ArmanAdilMangat/GENIE/enclosure/DESIGN_B_NO_TOF/SHEET.png

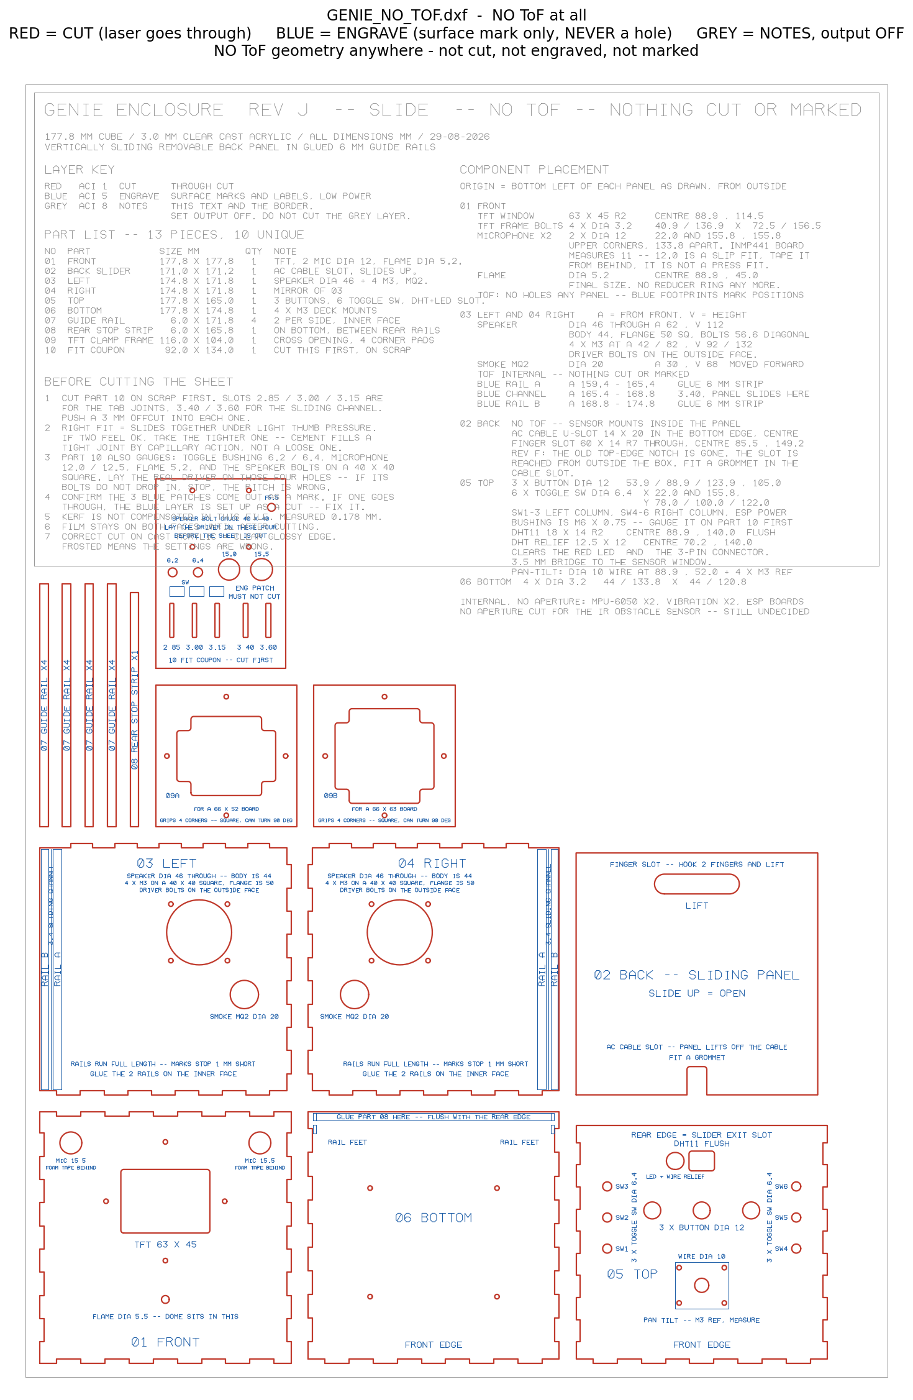
enclosure/DESIGN_B_NO_TOF/SHEET.png
