ArmanAdilMangat/GENIE/enclosure/PARTIAL_CUTS/COUPON_ONLY.png

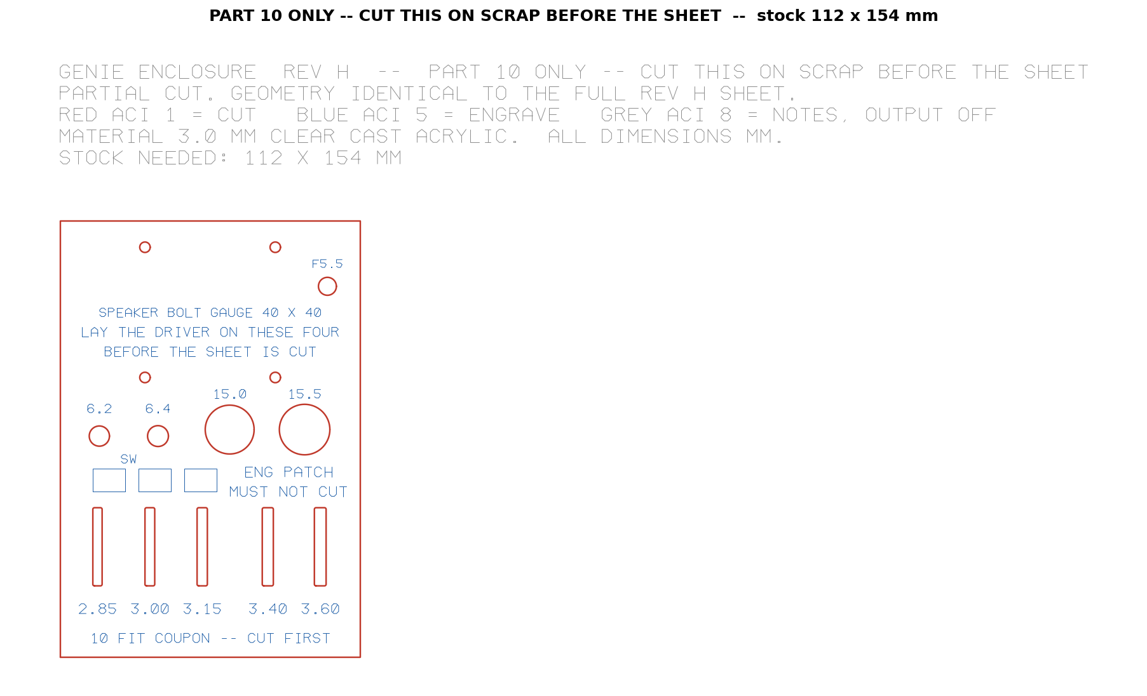
enclosure/PARTIAL_CUTS/COUPON_ONLY.png
