ArmanAdilMangat/GENIE/enclosure/PARTIAL_CUTS/REPLACEMENT_PANELS.png

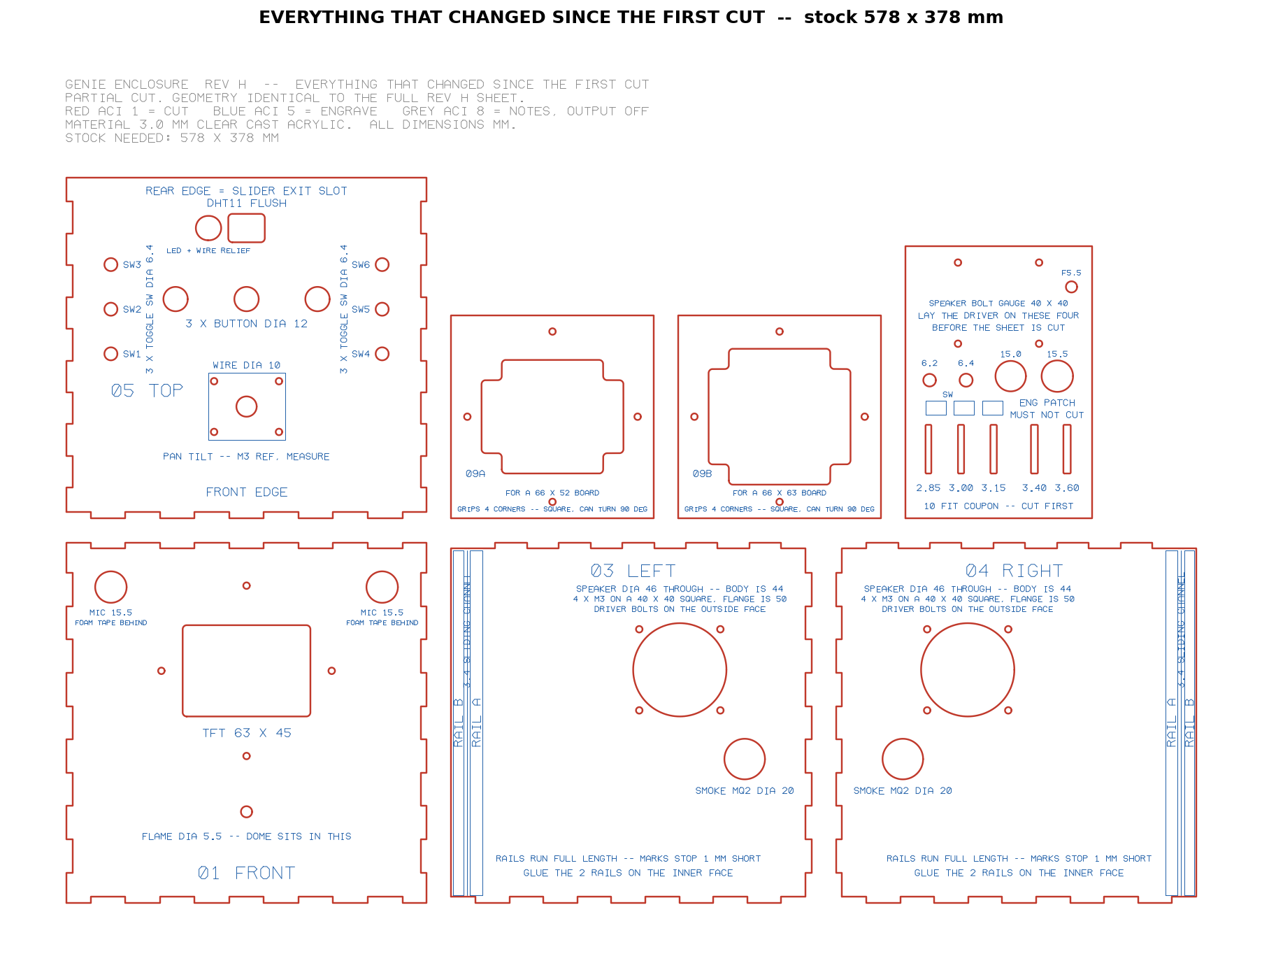
enclosure/PARTIAL_CUTS/REPLACEMENT_PANELS.png
