ArmanAdilMangat/GENIE/enclosure/PARTIAL_CUTS/SIDE_PANELS_ONLY.png

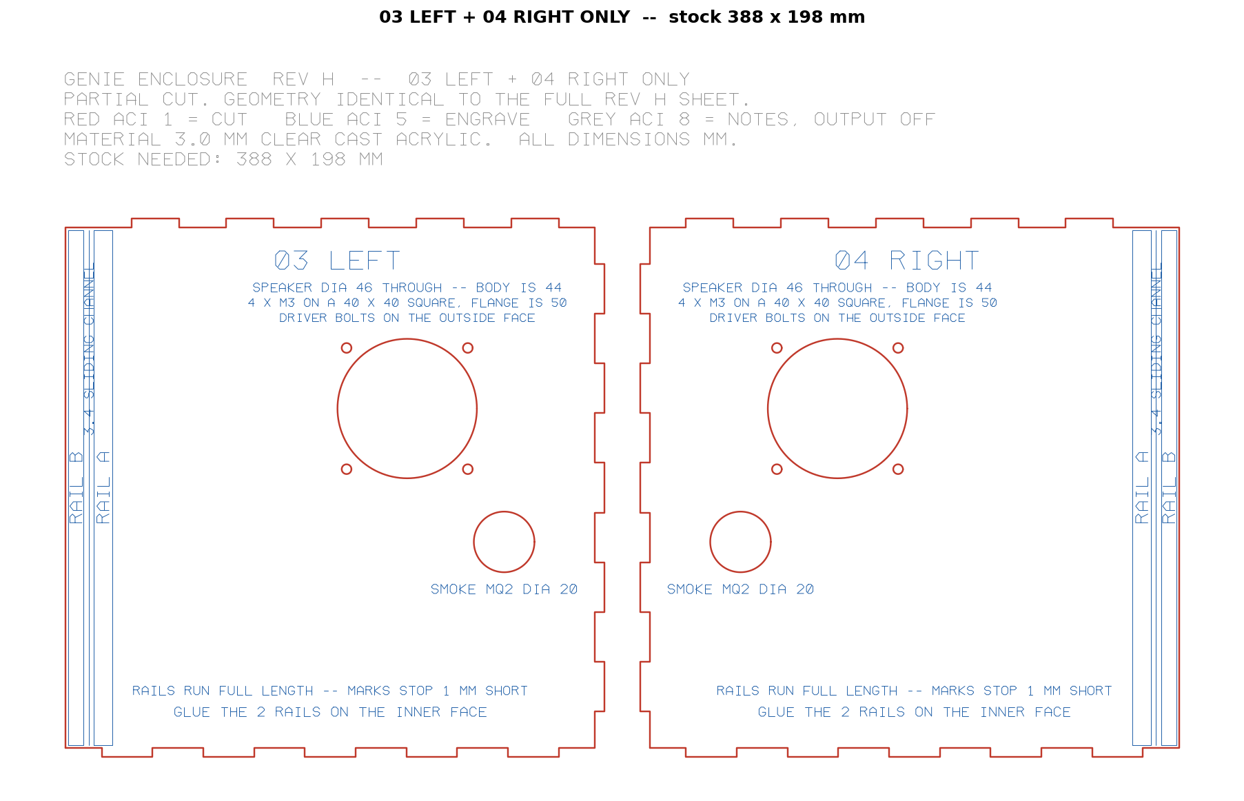
enclosure/PARTIAL_CUTS/SIDE_PANELS_ONLY.png
