ArmanAdilMangat/GENIE/enclosure/recut_2026-09-03/2_THREE_PLATES.png

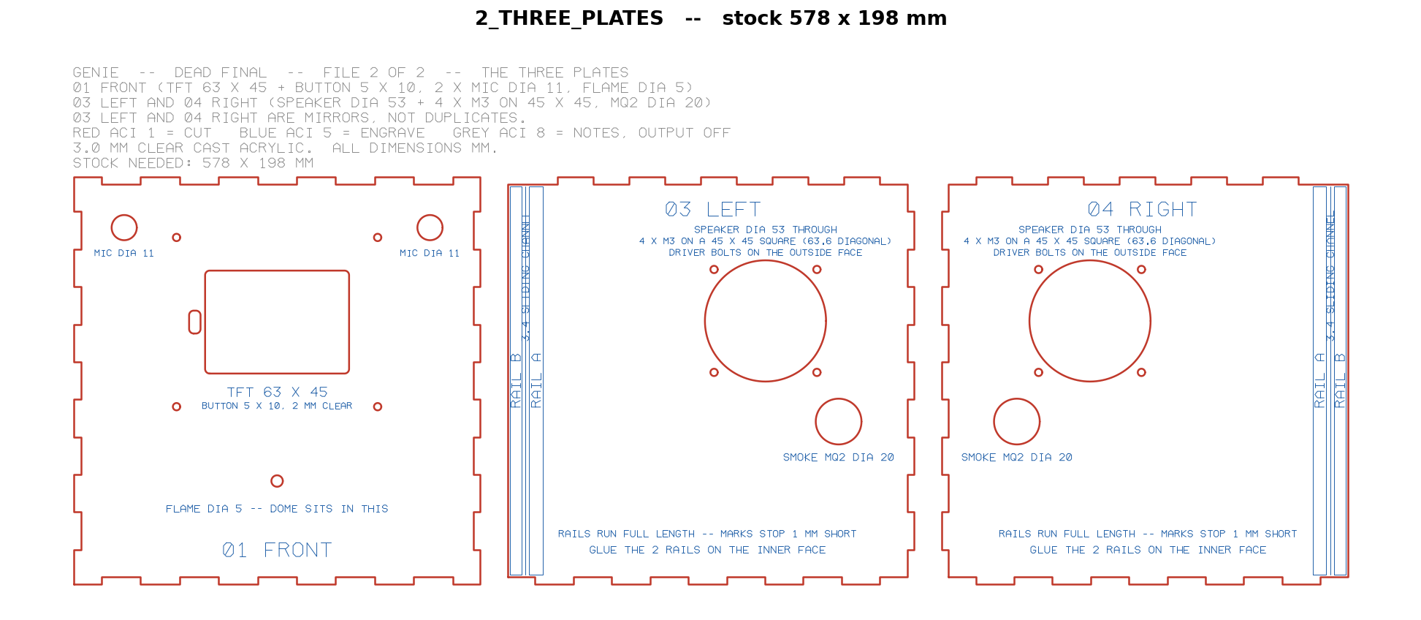
enclosure/recut_2026-09-03/2_THREE_PLATES.png
