ArmanAdilMangat/GENIE/enclosure/DESIGN_B_NO_TOF/GENIE_NO_TOF_blackred.dxf

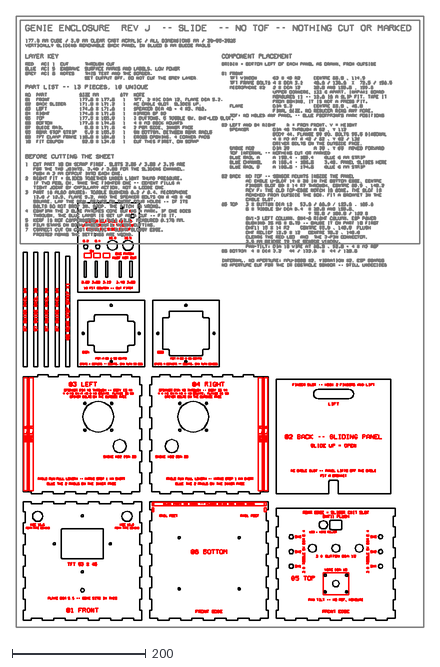
[picture p15: CAD file, 2026-10-06]
enclosure/DESIGN_B_NO_TOF/GENIE_NO_TOF_blackred.dxf
610.0 x 915.0
