ArmanAdilMangat/GENIE/enclosure/PARTIAL_CUTS/REPLACEMENT_PANELS.dxf

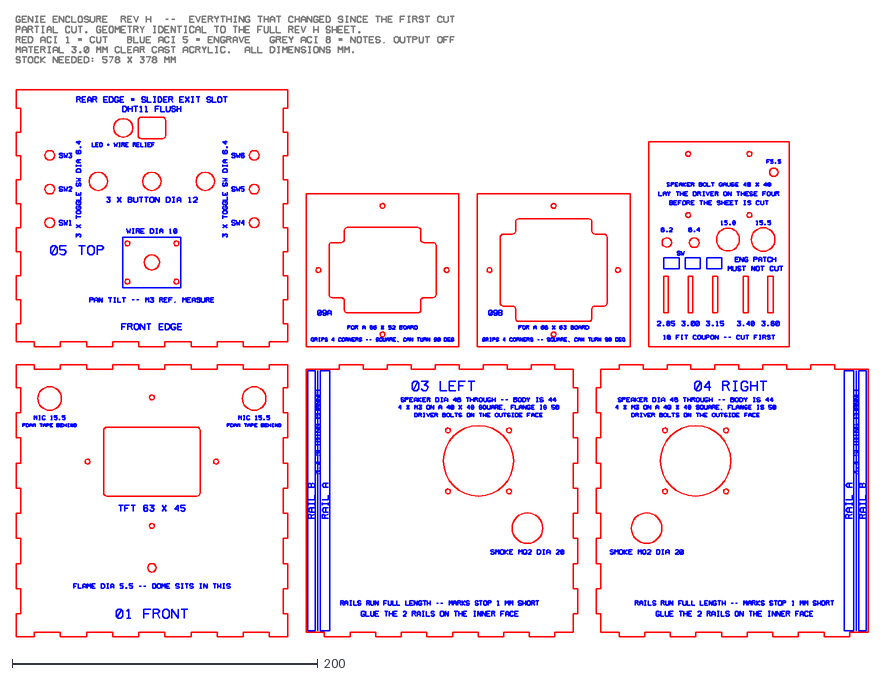
[picture p16: CAD file, 2026-10-06]
enclosure/PARTIAL_CUTS/REPLACEMENT_PANELS.dxf
557.4 x 405.8
