ArmanAdilMangat/GENIE/enclosure/recut_2026-09-03/1_TEST_TFT_MIC_SPEAKER.dxf

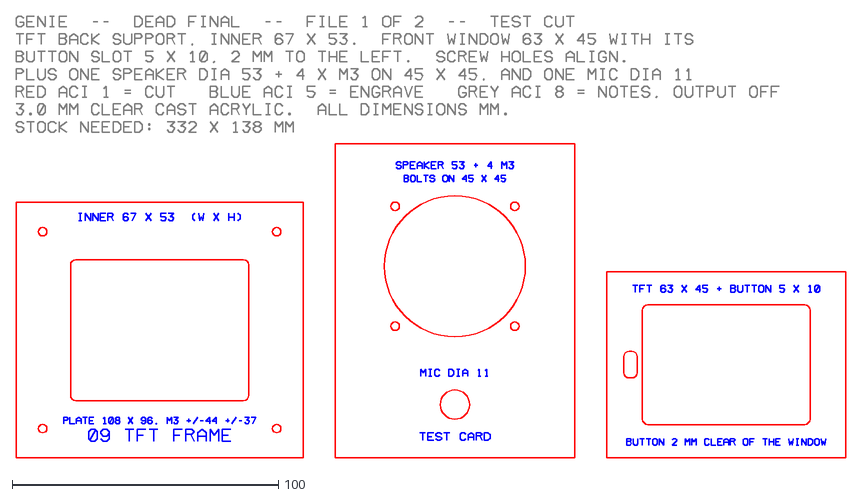
[picture p17: CAD file, 2026-10-06]
enclosure/recut_2026-09-03/1_TEST_TFT_MIC_SPEAKER.dxf
312.0 x 166.0
