ArmanAdilMangat/GENIE/enclosure/DESIGN_B_NO_TOF/GENIE_NO_TOF.dxf

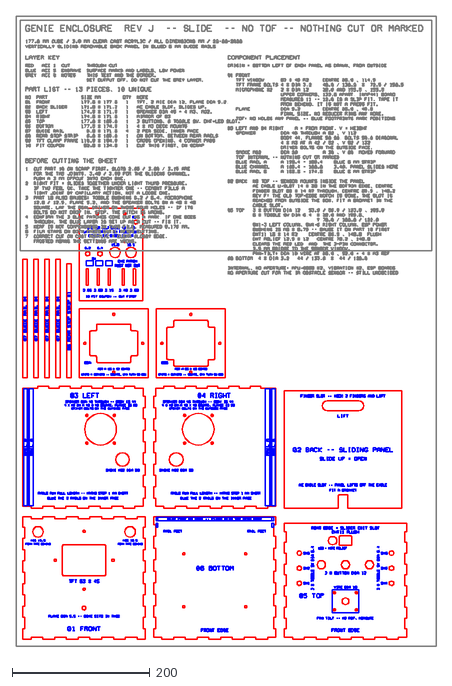
[picture p18: CAD file, 2026-10-06]
enclosure/DESIGN_B_NO_TOF/GENIE_NO_TOF.dxf
610.0 x 915.0
