ArmanAdilMangat/GENIE/enclosure/PARTIAL_CUTS/SIDE_PANELS_ONLY.dxf

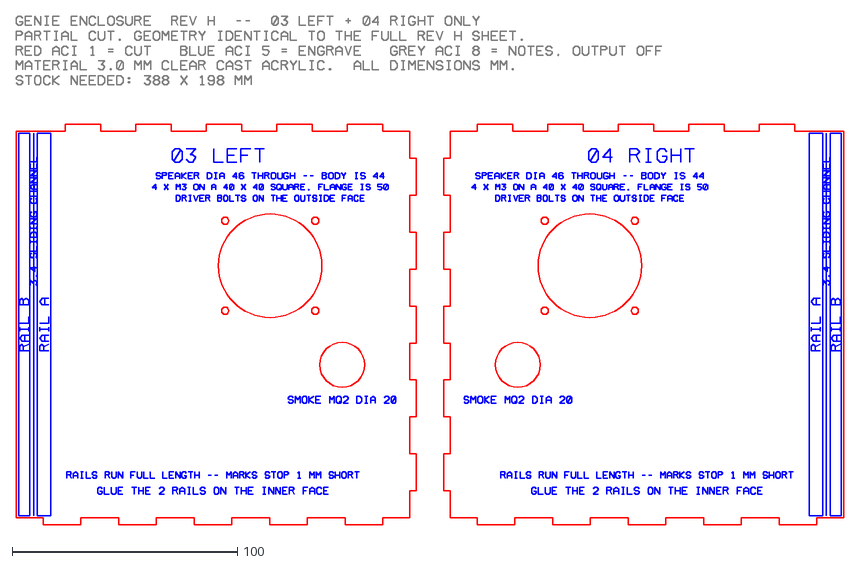
[picture p19: CAD file, 2026-10-06]
enclosure/PARTIAL_CUTS/SIDE_PANELS_ONLY.dxf
367.6 x 225.8
