ArmanAdilMangat/GENIE/enclosure/recut_2026-09-03/2_THREE_PLATES.dxf

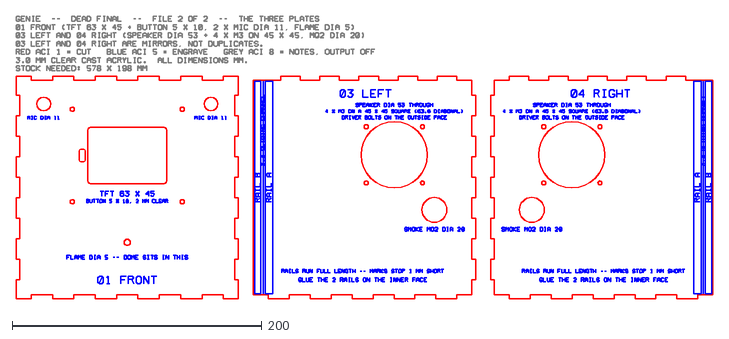
[picture p20: CAD file, 2026-10-06]
enclosure/recut_2026-09-03/2_THREE_PLATES.dxf
557.4 x 225.8
