ArmanAdilMangat/GENIE/enclosure/PARTIAL_CUTS/TEST_CUT_FIRST.dxf

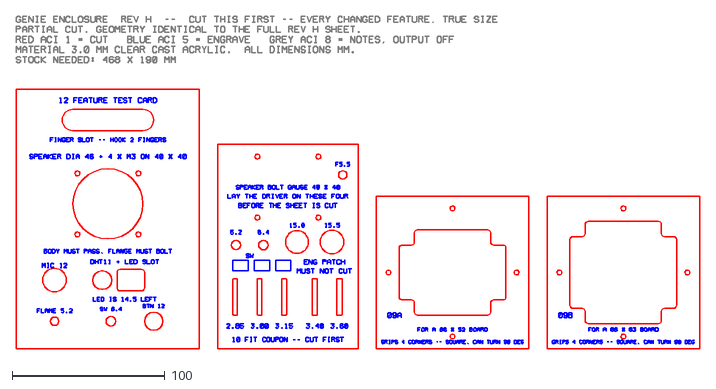
[picture p21: CAD file, 2026-10-06]
enclosure/PARTIAL_CUTS/TEST_CUT_FIRST.dxf
448.0 x 218.0
