ArmanAdilMangat/GENIE/enclosure/PARTIAL_CUTS/COUPON_ONLY.dxf

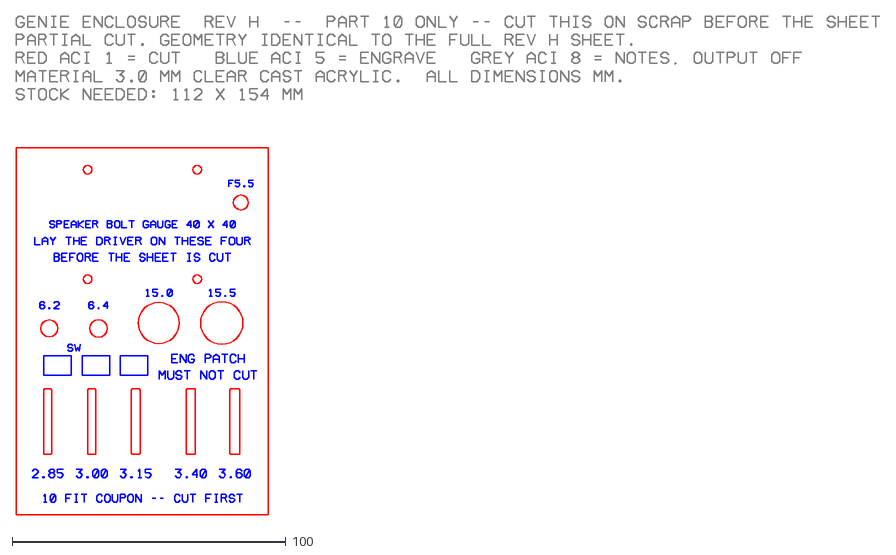
[picture p22: CAD file, 2026-10-06]
enclosure/PARTIAL_CUTS/COUPON_ONLY.dxf
315.3 x 182.0
