ArmanAdilMangat/GENIE/enclosure/PARTIAL_CUTS/TEST_CUT_FIRST.png

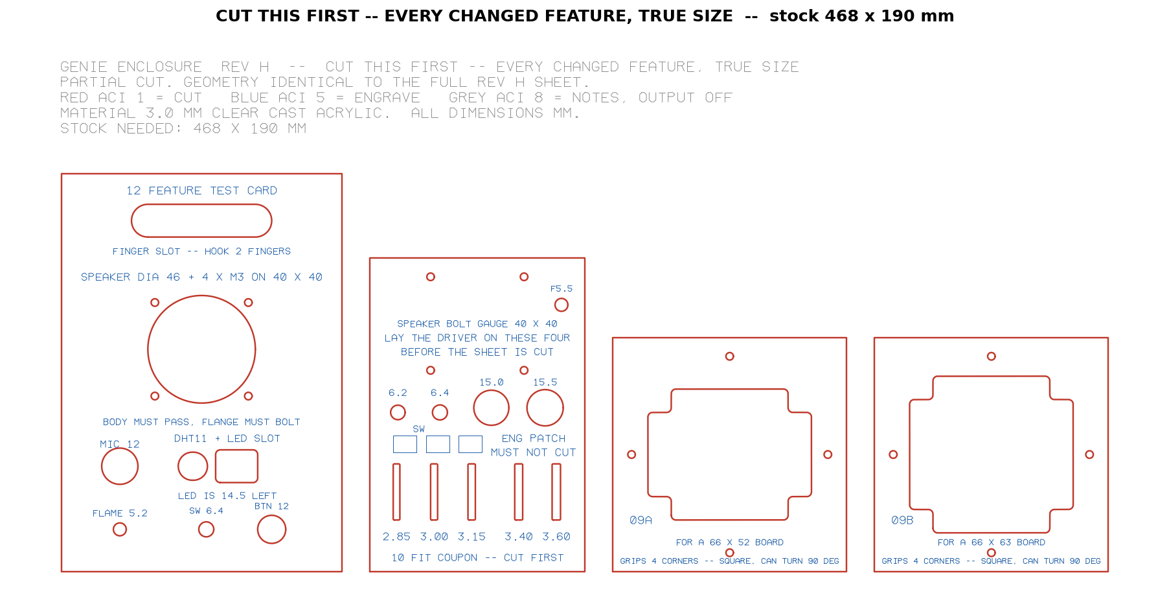
enclosure/PARTIAL_CUTS/TEST_CUT_FIRST.png
