ArmanAdilMangat/GENIE/enclosure/recut_2026-09-03/1_TEST_TFT_MIC_SPEAKER.png

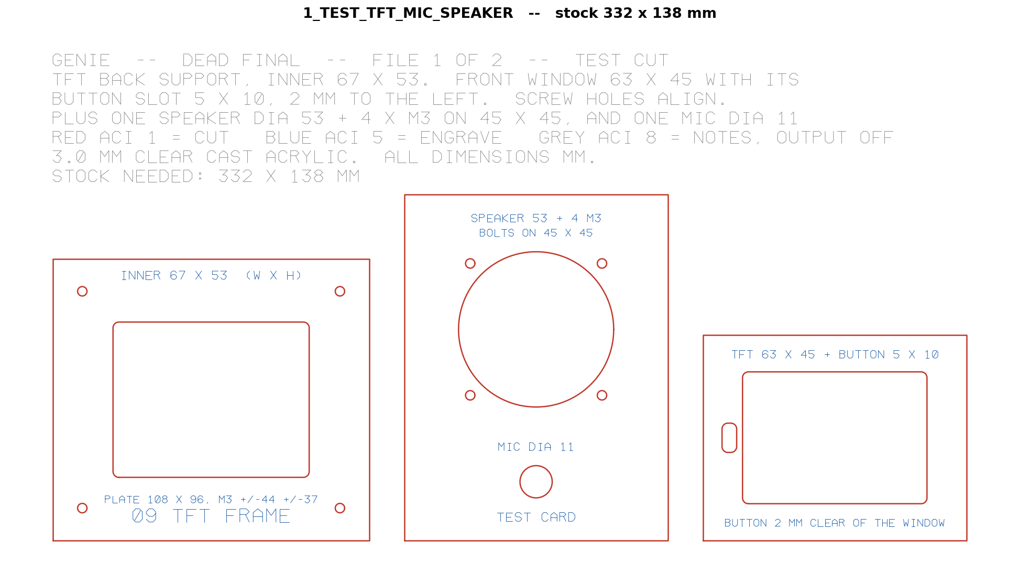
enclosure/recut_2026-09-03/1_TEST_TFT_MIC_SPEAKER.png
