ArmanAdilMangat/GENIE/(commit log)

2026-05-12 Initial commit — GENIE Phase 1 (firmware + server + docs)
2026-10-06 chore: move the Phase 1 prototype to legacy/phase1
    The single-board Flask + Whisper + pyttsx3 prototype is kept with its
    history. Its README now points at the repository root, and the ignore
    rules cover credentials and runtime state for the Phase 2 boards.
2026-10-06 feat: add Phase 2 sensor nodes, link contract and telemetry reader
    - firmware/link: the ESP-NOW frame, size derived from its format string
    - firmware/node1_face: display driver, face, sensors, UI, link receiver,
    per-sensor bench scripts and diagnostics
    - firmware/node2_presence: ToF array firmware as recovered from the board,
    calibration and the fault-isolation bench; WiFi credentials replaced by
    a template
    - firmware/r307s_fingerprint: verification suite and driver
    - host/serial_reader: runnable reference reader for the telemetry contract
    - tools/check_syntax.py: parse every Python file
    [CALIBRATE_AND_DETECT.py, LED_SWEEP.py, LED_TEST.py, QUICK_CHECK.py, R307S_01_LifeCheck.ino, R307S_02_FullTest.ino, TOF_ALL_TESTS.py]
2026-10-06 feat: add the Rev J enclosure: generator, audit and cut files
    One script generates the laser file, another audits it (21 checks). The
    committed DXF is reproduced by the generator apart from header timestamps.
    Includes the test-cut post-mortem, revision history and the 3 September
    replacement plates.
    [1_TEST_TFT_MIC_SPEAKER.dxf, 2_THREE_PLATES.dxf, COUPON_ONLY.dxf, GENIE_NO_TOF.dxf, GENIE_NO_TOF_blackred.dxf, REPLACEMENT_PANELS.dxf, SIDE_PANELS_ONLY.dxf, TEST_CUT_FIRST.dxf]
2026-10-06 feat(host): import the host pipeline
    Speech pipeline, FastAPI sensor store, alert / climate / reaction
    watchers, board simulator, monitor, AIML files and the wake-word model.
    Code by Muhammad Suhaib Mamoon, imported from the final submission.
    - Wi-Fi password and emergency contact replaced with placeholders
    - one genie_serial.py: the host copy, which carries the emotion-tag fix,
    replaces host/serial_reader/
    - Piper voice, Whisper and Mistral weights and the wake-word training
    audio are not included; host/README.md says where each comes from
    - tools/check_aiml.py and tools/check_secrets.py added
    [ai.py, config.py, genie_serial.py, sensor_watch.py, tof_bringup_standalone.py, wifi_cfg.example.py]
2026-10-06 feat(firmware): integrated sensor builds, audio nodes, modem node
    Node 1 gains the telemetry emitter, fall and handling state machines,
    the feature extractor and the exported 232-parameter classifier. Node 2
    moves to the integrated build; the bring-up script found on the board on
    2 September is kept under bench/. The three files both sensor boards
    must share now live once, in firmware/link/.
    Adds the microphone, speaker and A7670E modem node firmware
    (MicroPython). modem.py is kept once, in host/Services/. The relay
    node's firmware was not in the submission and is not here.
2026-10-06 fix(host): first alert dropped after a cold start; elevated smoke reported as all clear
    sensor_watch: _last_alert started at 0.0 and was compared with
    time.monotonic(), which counts from boot on Windows. On a machine up for
    less than the 600 s cooldown the first alert was suppressed, and because
    its edge was already consumed it never fired. Start at minus infinity.
    ai: the all-sensors summary only reached 'warning' for motion, so smoke
    at 'elevated' fell through to 'ok' and the answer was all clear. Use the
    warning sentence sensor.aiml already carries.
    Adds host/tests/test_alert_policy.py: 15 tests on a fake clock covering
    the edge, per-sensor debounce, the shared cooldown and unknown-vers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
    [ai.py, sensor_watch.py]
